myelin/modular-arm-usb/README.md

Multi-purpose board with:

- usb type A plug
- 3v3 ldo (from usb)
- lpc11u14, swd connector, pullups, caps
- some broken-out gpio (including uart, i2c, spi)
- led (ws2812b?)
- nrf24l01+
- battery connector (or maybe just a generic power input)
- fuse
