myelin/modular-arm-usb/pcb/parts/myelin/README.md

Various parts and footprints from Phillip Pearson -- https://github.com/myelin
