myelin/modular-arm-usb/pcb/modular-arm-usb.kicad_pcb

## KiCad design pcb/modular-arm-usb.kicad_pcb (2015-01-14)

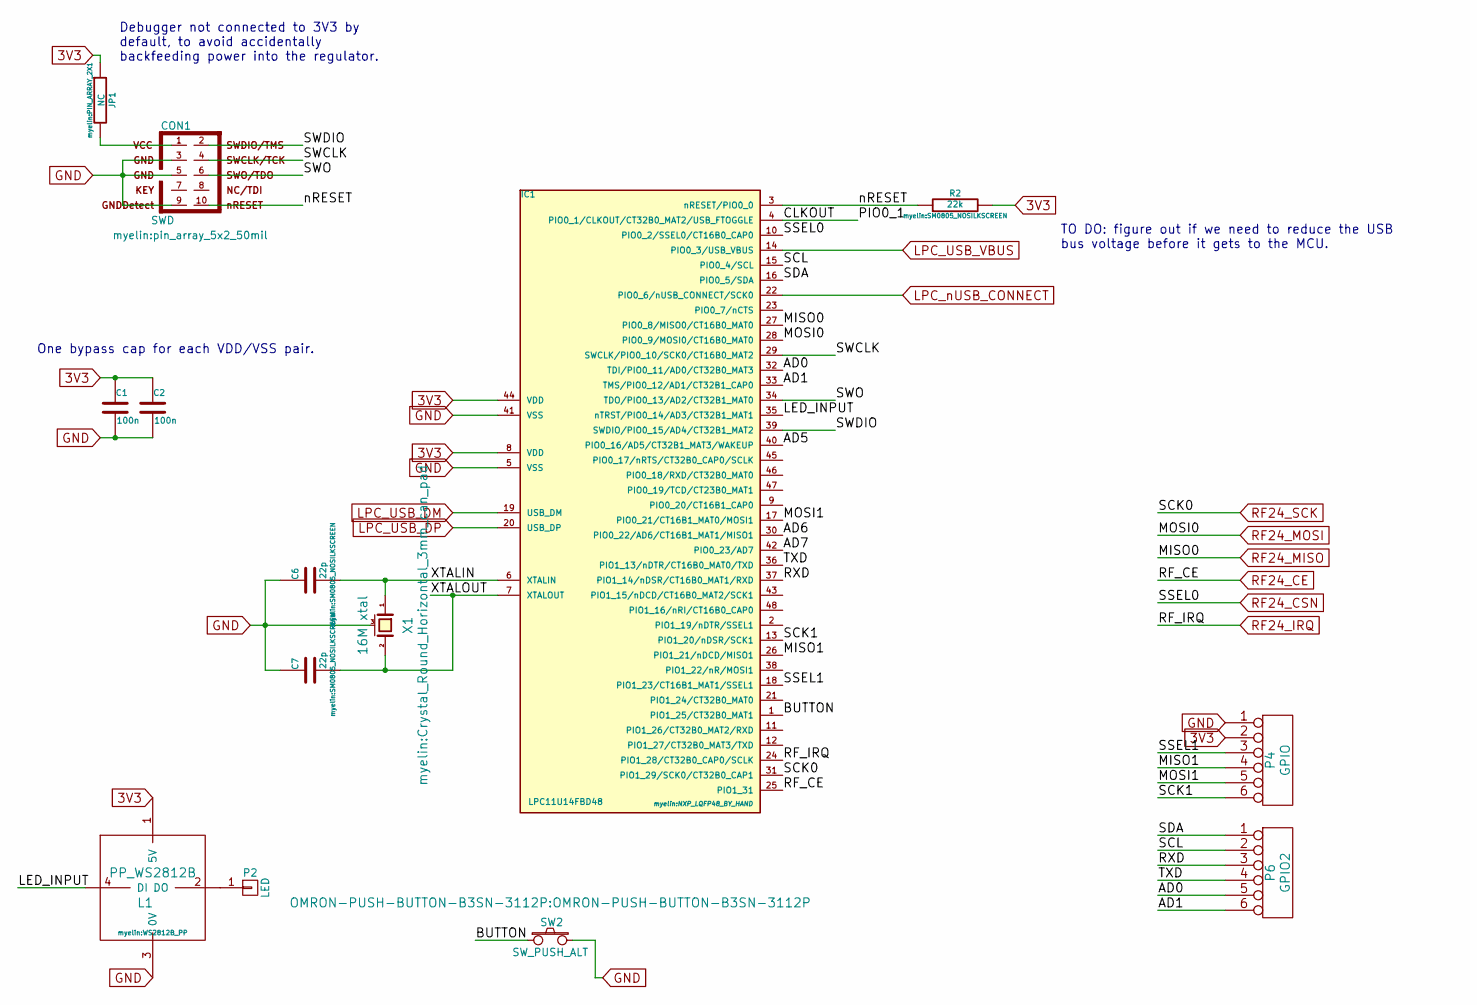
[picture p1: schematic lpc-mcu.sch]

Parts:
C1, C2: 100n; SM0805_NOSILKSCREEN
C6, C7: 22p; SM0805_NOSILKSCREEN
CON1: SWD; pin_array_5x2_50mil
IC1: LPC11U14FBD48; NXP_LQFP48_BY_HAND
JP1: NC; PIN_ARRAY_2X1
L1: PP_WS2812B; WS2812B_PP
P2: LED; Pin_Header_Straight_1x01
P4: GPIO; PIN_ARRAY_6X1
P6: GPIO2; PIN_ARRAY_6X1
R2: 22k; SM0805_NOSILKSCREEN
SW2: SW_PUSH_ALT; OMRON-PUSH-BUTTON-B3SN-3112P
X1: 16M xtal; Crystal_Round_Horizontal_3mm_can_pad

Connections:
3V3: C1.1, C2.1, IC1.8 (VDD), IC1.44 (VDD), JP1.1, L1.1 (5V), P4.2, R2.2; also elsewhere on the board
/lpc-mcu/AD0: IC1.32 (TDI/PIO0_11/AD0/CT32B0_MAT3), P6.5
/lpc-mcu/AD1: IC1.33 (TMS/PIO0_12/AD1/CT32B1_CAP0), P6.6
/lpc-mcu/AD5: IC1.40 (PIO0_16/AD5/CT32B1_MAT3/WAKEUP)
/lpc-mcu/AD6: IC1.30 (PIO0_22/AD6/CT16B1_MAT1/MISO1)
/lpc-mcu/AD7: IC1.42 (PIO0_23/AD7)
/lpc-mcu/BUTTON: IC1.1 (PIO1_25/CT32B0_MAT1), SW2.1
/lpc-mcu/CLKOUT: IC1.4 (PIO0_1/CLKOUT/CT32B0_MAT2/USB_FTOGGLE)
/lpc-mcu/LED_INPUT: IC1.35 (nTRST/PIO0_14/AD3/CT32B1_MAT1), L1.4 (DI)
/lpc-mcu/MISO1: IC1.26 (PIO1_21/nDCD/MISO1), P4.4
/lpc-mcu/MOSI1: IC1.17 (PIO0_21/CT16B1_MAT0/MOSI1), P4.5
/lpc-mcu/RXD: IC1.37 (PIO1_14/nDSR/CT16B0_MAT1/RXD), P6.3
/lpc-mcu/SCK1: IC1.13 (PIO1_20/nDSR/SCK1), P4.6
/lpc-mcu/SCL: IC1.15 (PIO0_4/SCL), P6.2
/lpc-mcu/SDA: IC1.16 (PIO0_5/SDA), P6.1
/lpc-mcu/SSEL1: IC1.18 (PIO1_23/CT16B1_MAT1/SSEL1), P4.3
/lpc-mcu/SWCLK: CON1.4, IC1.29 (SWCLK/PIO0_10/SCK0/CT16B0_MAT2)
/lpc-mcu/SWDIO: CON1.2, IC1.39 (SWDIO/PIO0_15/AD4/CT32B1_MAT2)
/lpc-mcu/SWO: CON1.6, IC1.34 (TDO/PIO0_13/AD2/CT32B1_MAT0)
/lpc-mcu/TXD: IC1.36 (PIO1_13/nDTR/CT16B0_MAT0/TXD), P6.4
/lpc-mcu/XTALIN: C6.2, IC1.6 (XTALIN), X1.1
/lpc-mcu/XTALOUT: C7.2, IC1.7 (XTALOUT), X1.2
/lpc-mcu/nRESET: CON1.10, IC1.3 (nRESET/PIO0_0), R2.1
GND: C1.2, C2.2, C6.1, C7.1, CON1.3, CON1.5, CON1.9, IC1.5 (VSS), IC1.41 (VSS), L1.3 (0V), P4.1, SW2.3, X1.3 (case); also elsewhere on the board
LPC_USB_DM: IC1.19 (USB_DM); also elsewhere on the board
LPC_USB_DP: IC1.20 (USB_DP); also elsewhere on the board
LPC_USB_VBUS: IC1.14 (PIO0_3/USB_VBUS)
LPC_nUSB_CONNECT: IC1.22 (PIO0_6/nUSB_CONNECT/SCK0)
unnamed: CON1.1, JP1.2
unnamed: L1.2 (DO), P2.1
RF24_CE: IC1.25 (PIO1_31); also elsewhere on the board
RF24_CSN: IC1.10 (PIO0_2/SSEL0/CT16B0_CAP0); also elsewhere on the board
RF24_IRQ: IC1.24 (PIO1_28/CT32B0_CAP0/SCLK); also elsewhere on the board
RF24_MISO: IC1.27 (PIO0_8/MISO0/CT16B0_MAT0); also elsewhere on the board
RF24_MOSI: IC1.28 (PIO0_9/MOSI0/CT16B0_MAT0); also elsewhere on the board
RF24_SCK: IC1.31 (PIO1_29/SCK0/CT32B0_CAP1); also elsewhere on the board

Notes on the sheet:
Debugger not connected to 3V3 by default, to avoid accidentally backfeeding power into the regulator.
One bypass cap for each VDD/VSS pair.
TO DO: figure out if we need to reduce the USB bus voltage before it gets to the MCU.

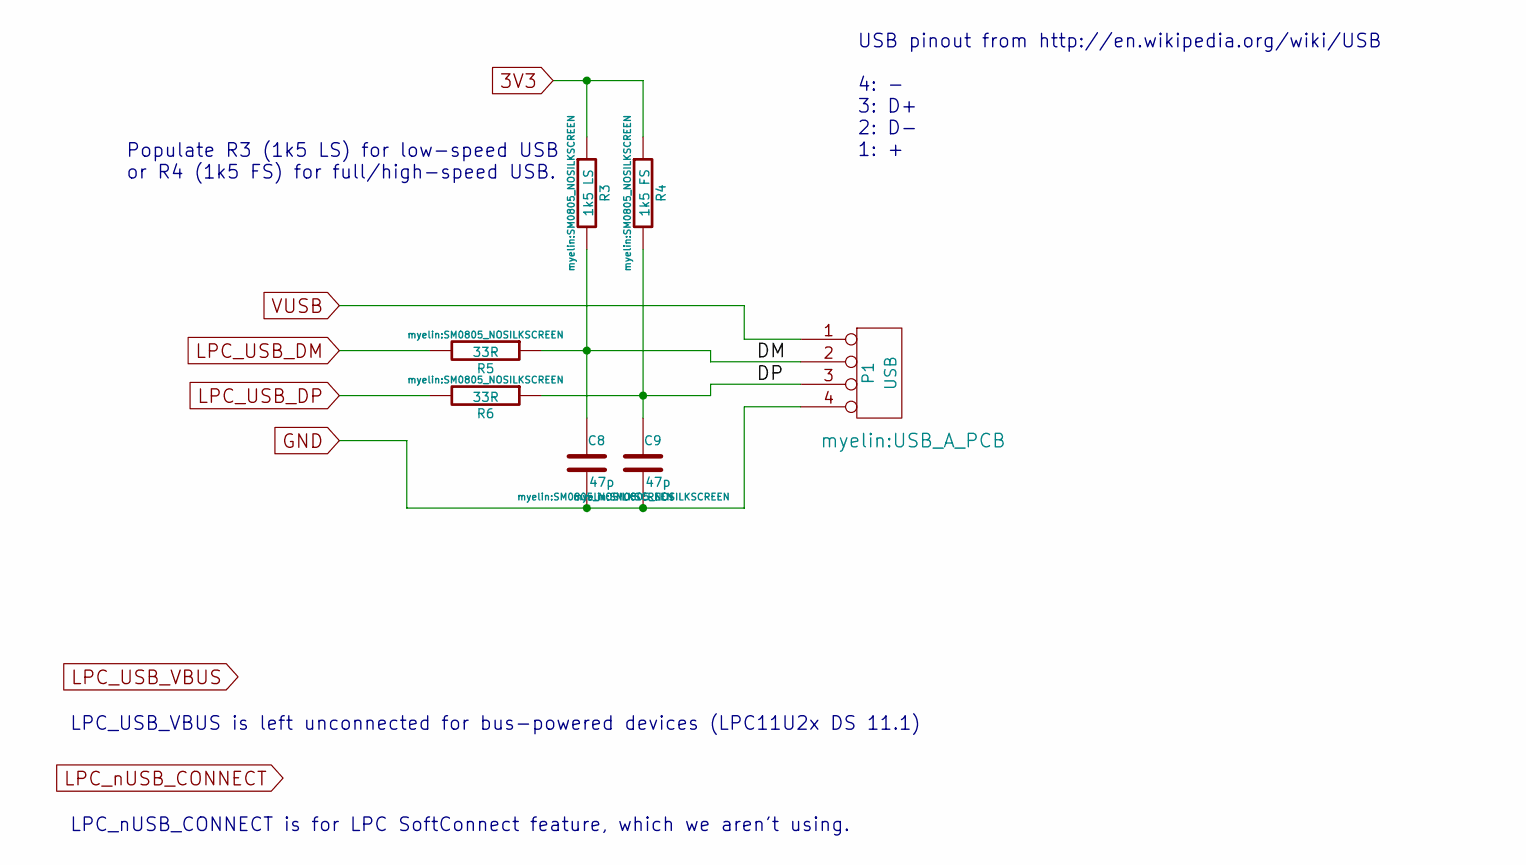
[picture p2: schematic usb.sch]

Parts:
C8, C9: 47p; SM0805_NOSILKSCREEN
P1: USB; USB_A_PCB
R3: 1k5 LS; SM0805_NOSILKSCREEN
R4: 1k5 FS; SM0805_NOSILKSCREEN
R5, R6: 33R; SM0805_NOSILKSCREEN

Connections:
3V3: R3.1, R4.1; also elsewhere on the board
/usb/DM: C8.1, P1.2, R3.2, R5.1
/usb/DP: C9.1, P1.3, R4.2, R6.1
GND: C8.2, C9.2, P1.4; also elsewhere on the board
LPC_USB_DM: R5.2; also elsewhere on the board
LPC_USB_DP: R6.2; also elsewhere on the board
VUSB: P1.1; also elsewhere on the board

Notes on the sheet:
LPC_nUSB_CONNECT is for LPC SoftConnect feature, which we aren't using.
LPC_USB_VBUS is left unconnected for bus-powered devices (LPC11U2x DS 11.1)
USB pinout from http://en.wikipedia.org/wiki/USB 4: - 3: D+ 2: D- 1: +
Populate R3 (1k5 LS) for low-speed USB or R4 (1k5 FS) for full/high-speed USB.

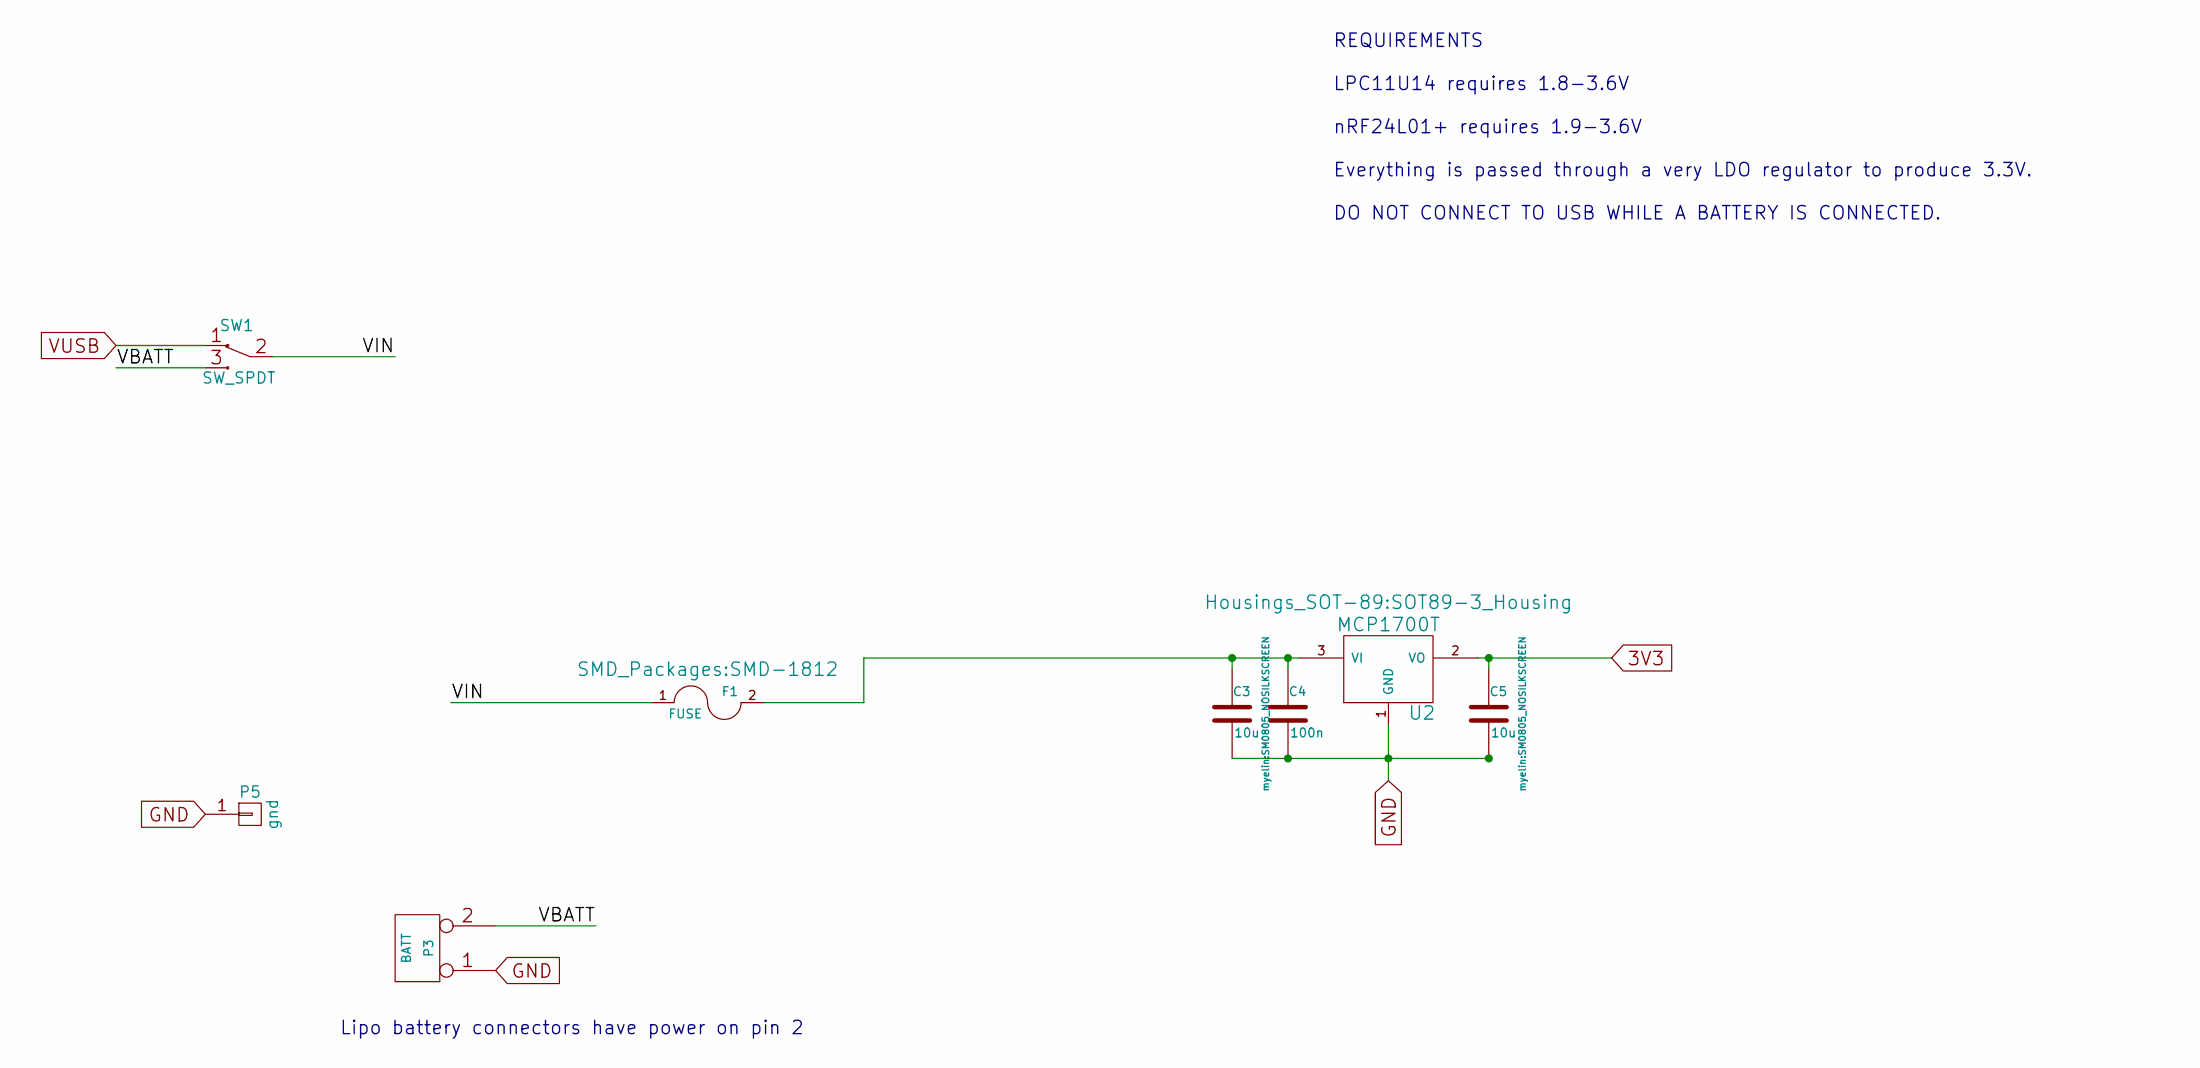
[picture p3: schematic power.sch]

Parts:
C3, C5: 10u; SM0805_NOSILKSCREEN
C4: 100n; SM0805_NOSILKSCREEN
F1: FUSE; SMD-1812
P3: BATT; S2B-PH-SM4-TB(LF)(SN)
P5: gnd; Pin_Header_Straight_1x01
SW1: SW_SPDT; PIN_ARRAY_3X1
U2: MCP1700T; SOT89-3_Housing

Connections:
3V3: C5.1, U2.2 (VO); also elsewhere on the board
/power/VBATT: P3.2 (PM), SW1.3 (NO)
/power/VIN: F1.1, SW1.2 (COM)
GND: C3.2, C4.2, C5.2, P3.1, P5.1, U2.1 (GND); also elsewhere on the board
unnamed: C3.1, C4.1, F1.2, U2.3 (VI)
VUSB: SW1.1 (NC); also elsewhere on the board

Notes on the sheet:
Lipo battery connectors have power on pin 2
REQUIREMENTS LPC11U14 requires 1.8-3.6V nRF24L01+ requires 1.9-3.6V Everything is passed through a very LDO regulator to produce 3.3V. DO NOT CONNECT TO USB WHILE A BATTERY IS CONNECTED.

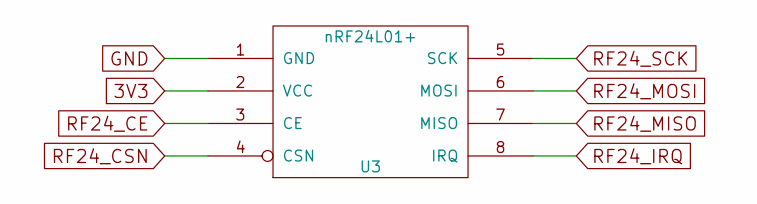
[picture p4: schematic nrf24l01p.sch]

Parts:
U3: nRF24L01+; NRF24L01_MODULE

Connections:
3V3: U3.2 (VCC); also elsewhere on the board
GND: U3.1 (GND); also elsewhere on the board
RF24_CE: U3.3 (CE); also elsewhere on the board
RF24_CSN: U3.4 (CSN); also elsewhere on the board
RF24_IRQ: U3.8 (IRQ); also elsewhere on the board
RF24_MISO: U3.7 (MISO); also elsewhere on the board
RF24_MOSI: U3.6 (MOSI); also elsewhere on the board
RF24_SCK: U3.5 (SCK); also elsewhere on the board

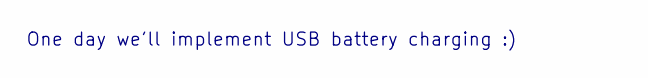
[picture p5: schematic charging.sch]

Notes on the sheet:
One day we'll implement USB battery charging :)

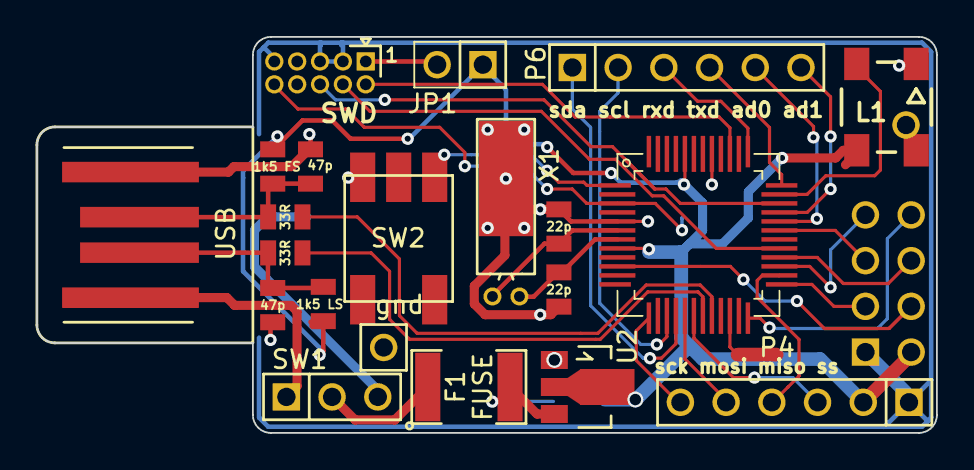
[picture p6: board modular-arm-usb.kicad_pcb from above]

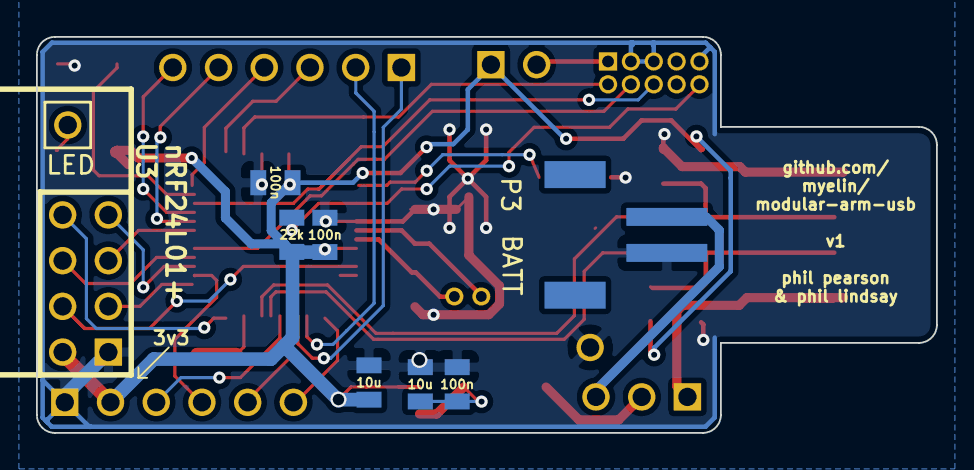
[picture p7: board modular-arm-usb.kicad_pcb from below]

Board: 2 copper layers, 50.0 x 22.0 mm, 30 parts (9 on the bottom side), 36 nets.
