myelin/modular-arm-usb/(threads)

Thread 16 (2014-12-28):

Add pushbutton

follower, 2014-12-28:

follower, 2015-01-04:
From `UM10462-LPC11Uxx.pdf`:

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

With the additional note (useful if we use a pull-up resistor):

> **7.3.4 Input inverter**
> If the input inverter is enabled, a HIGH pin level is inverted to 0 and a LOW pin level is inverted to 1.

As such, I suggest we connect the push button to ground, then enable the pull-up and (optionally) input inverter in software.

In terms of which input pin to use (they're mostly interchangeable apart from the obvious special purpose ones) I suggest just picking whatever is easiest to route.

follower, 2015-01-05:
Added symbol & footprint via: dd8db1db5ba5befc9ece03c8c793b4d07687103a, 92678bc670e17105302f3be0f1d76d7f90e72a87 & b973642893017d6175ceb129be622d89153dc02a

follower, 2015-01-06:
pp: "throw it on some arbitrary pin and i'll move it around if necessary"

follower, 2015-02-21:
BTW pushbutton ended up on PIO1_25.

follower, 2015-02-22:
Closing 'cos it's added and working.

Closed 2015-02-22.

Thread 18 (2015-01-04):

Add On/Off switch for battery power?

follower, 2015-01-04:
Adding a small SMD On/Off switch (or, at least the possibility to add one) in-line with the battery would be helpful. (Maybe route a solder jumper--with a default connecting trace--in parallel with the switch footprint?)

The (not cheap) standard FabLab switch is: [`401-2012-1-ND : SWITCH SLIDE SPDT 12V 100MA GW-` ](http://www.digikey.com/product-detail/en/AYZ0102AGRLC/401-2012-1-ND/1640121)

Thread 19 (2015-02-22):

Ensure board width doesn't prevent other devices from being plugged into adjacent USB ports

follower, 2015-02-22:
