myelin/modular-arm-usb/(commit log)

2014-12-26 initial import - blank project
    [modular-arm-usb.kicad_pcb, modular-arm-usb.sch]
2014-12-26 created sheets for modules
    [charging.sch, lpc-mcu.sch, nrf24l01p.sch, power.sch, usb.sch]
2014-12-26 added ARM SWD header library
2014-12-26 first cut of the power system
    [charging.sch, lpc-mcu.sch, modular-arm-usb.sch, nrf24l01p.sch, power.sch, usb.sch]
2014-12-26 JST PH battery connector
2014-12-26 started on lpc-mcu and ucb sheets
    [charging.sch, lpc-mcu.sch, nrf24l01p.sch, usb.sch]
2014-12-26 moved everything into follower's preferred project layout
    [charging.sch, lpc-mcu.sch, modular-arm-usb.kicad_pcb, modular-arm-usb.sch, nrf24l01p.sch, power.sch, usb.sch]
2014-12-26 put nrf24l01p.sch into the proper place in the hierarchy
    [nrf24l01p.sch]
2014-12-26 added SWD connector
    [lpc-mcu.sch, nrf24l01p.sch]
2014-12-26 added reset pullup, some caps, usb resistors, explanation for nUSB_CONNECT
    [lpc-mcu.sch, nrf24l01p.sch, power.sch, usb.sch]
2014-12-26 tied up some loose ends in power.sch
    [charging.sch, power.sch]
2014-12-26 thought through power situation a bit more, added some TO DO messages
    [lpc-mcu.sch, power.sch, usb.sch]
2014-12-26 added second 3v3 ldo in parallel with the first one, so we can have the option at build time
    [power.sch]
2014-12-26 made a usb-a plug from usb-if and wikipedia docs
    [lpc-mcu.sch, modular-arm-usb.kicad_pcb, nrf24l01p.sch, power.sch, usb.sch]
2014-12-27 made a footprint for the lpc11u14 that should be nice to hand solder
    [charging.sch, lpc-mcu.sch, modular-arm-usb.kicad_pcb, modular-arm-usb.sch, nrf24l01p.sch, power.sch, usb.sch]
2014-12-27 pulled in regulator footprint, started on pcb
    [lpc-mcu.sch, modular-arm-usb.kicad_pcb]
2014-12-27 power and usb - a bit more progress
    [lpc-mcu.sch, modular-arm-usb.kicad_pcb, power.sch, usb.sch]
2014-12-27 added LED, and removed VLED from power sheet
    [lpc-mcu.sch, modular-arm-usb.kicad_pcb, power.sch]
2014-12-27 some labels, and changed sm0805 parts to use my nosilkscreen package
    [lpc-mcu.sch, modular-arm-usb.kicad_pcb]
2014-12-27 gpios and rf24 connections
    [lpc-mcu.sch, modular-arm-usb.kicad_pcb, power.sch]
2014-12-27 Add footprints from <http://smisioto.no-ip.org/kicad_libs/modules/mod_smd_trans.zip> for SOT23.
2014-12-27 Add the footprint library with SOT23 to the project.
2014-12-27 Duplicate the SOT23 footprint to SOT23-ALT to change the pin numbers (this may not be necessary just to change the pin numbering?).
2014-12-27 Add symbols from <http://smisioto.no-ip.org/kicad_libs/library/lib_w_analog.zip> to use as base for LM3480 symbol.
2014-12-28 switched everything to native line endings
    [charging.sch, lpc-mcu.sch, modular-arm-usb.kicad_pcb, modular-arm-usb.sch, nrf24l01p.sch, power.sch, usb.sch]
2014-12-28 fixed line endings on the last couple of files, and copied in my standard .gitignore
2015-01-03 updated kicad to latest version and fixed things that didn't show up properly (text, nrf24l01+ part)
    [charging.sch, lpc-mcu.sch, modular-arm-usb.kicad_pcb, modular-arm-usb.sch, nrf24l01p.sch, power.sch, usb.sch]
2015-01-04 Upgraded all modules to new kicad_mod/pretty format. Added MCP1700T-3302 regulator and cleaned up power circuit. Getting closer to final power/USB placement.
    [charging.sch, lpc-mcu.sch, modular-arm-usb.kicad_pcb, modular-arm-usb.sch, nrf24l01p.sch, power.sch, usb.sch]
2015-01-05 Add module for FabLab standard Omron Push Button from my previous project at <https://github.com/follower/led-spinner-toy/blob/master/pcb/parts/rancidbacon/OMRON-PUSH-BUTTON-B3SN-3112P.mod>.
2015-01-05 Import discrete device/components library from <http://smisioto.no-ip.org/kicad_libs/library/lib_w_device.zip> version (22/06/2013).
2015-01-05 Add the alternate pinout push button that I originally created for the reaction tester game project from the <http://smisioto.no-ip.org/> device library.
2015-01-06 moved things around on the pcb a bit, made it more compact
    [lpc-mcu.sch, modular-arm-usb.kicad_pcb]
2015-01-10 Add reference to alternate pushbutton symbol.
    [charging.sch, lpc-mcu.sch, modular-arm-usb.sch, nrf24l01p.sch, power.sch, usb.sch]
2015-01-10 Add pushbutton to schematic. Usign Pin 36 currently because it's a currently unused corner pin facing away from currently routed part of the PCB.
    [lpc-mcu.sch]
2015-01-10 Add reference to pushbutton switch library footprint to footprint tables.
2015-01-10 Add device library reference for source of switch.
    [charging.sch, lpc-mcu.sch, modular-arm-usb.sch, nrf24l01p.sch, power.sch, usb.sch]
2015-01-10 Add power choice slide switch to the schematic.
    [power.sch]
2015-01-10 Let the slide switch symbol be added to the cache.
2015-01-13 pcb work from last night
    [lpc-mcu.sch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]
2015-01-14 moved TXD and RXD to pins that give shorter traces, and attempted to route USB_CONNECT / implement SoftConnect, but gave up
    [lpc-mcu.sch, modular-arm-usb.kicad_pcb]
2015-01-14 added a big empty track segment in case we want access to USB_CONNECT in an emergency
    [modular-arm-usb.kicad_pcb]
2015-01-14 gerbers for oshpark order
    [modular-arm-usb-B_Cu.gbl, modular-arm-usb-B_Mask.gbs, modular-arm-usb-B_Paste.gbp, modular-arm-usb-B_SilkS.gbo, modular-arm-usb-Edge_Cuts.gbr, modular-arm-usb-F_Cu.gtl, modular-arm-usb-F_Mask.gts, modular-arm-usb-F_Paste.gtp]
